horacekj/bcthesis/README.md

# Systém automatické kalibrace modelového železničního vozidla
(Honzova bakalářka)

Tento repozitář obsahuje bakalářskou práci Jana Horáčka vypracovávanou v roce
2018 na Fakultě informatiky Masarykovy univerzity.

Práce je psána v českém jazyce.

HW & FW & SW vyvíjený v rámci práce:

 * [WSM PCB](https://github.com/kmzbrnoI/wsm-pcb)
 * [WSM FW](https://github.com/kmzbrnoI/wsm-fw)
 * [WSM Speed Reader](https://github.com/kmzbrnoI/wsm-speed-reader)
 * [Automatic Calibration SW](https://github.com/kmzbrnoI/automatic-calibration)

## Sestavení práce

Pro sestavení této práce je nutný LaTeX balíček
[fithesis3](https://www.fi.muni.cz/lemma/projekty/fithesis3/). Doporučujeme
použít [Honzův vlastní fork](https://github.com/horacekj/fithesis3).

Pro sestavení stačí spustit
```
$ make all
```
