horacekj/bcthesis/thesis.tex

\documentclass[digital, oneside, table, nolot, nolof]{fithesis3}
%\documentclass[printed, twoside, table, nolot, nolof]{fithesis3}

%% The following section sets up the locales used in the thesis.
\usepackage[resetfonts]{cmap}
\usepackage[T1]{fontenc}
\usepackage[main=czech, english]{babel}

%% The following section sets up the metadata of the thesis.
\thesissetup{
    date          = \the\year/\the\month/\the\day,
    university    = mu,
    faculty       = fi,
    type          = bc,
    author        = Jan Horáček,
    gender        = m,
    advisor       = {RNDr. Zdeněk Matěj, Ph.D.},
    title         = {Systém automatické kalibrace modelového železničního vozidla},
    TeXtitle      = {Systém automatické kalibrace modelového železničního vozidla},
    keywords      = {kalibrace, dcc, vlak, vůz, model, senzor, C++, qt, bluetooth, cv},
    TeXkeywords   = {kalibrace, dcc, vlak, vůz, model, senzor, C++, qt, bluetooth, cv},
    abstract      = {\input{abstrakt.tex}},
    thanks        = {\input{dik.tex}},
    bib           = bibliography.bib,
    titleEn       = {Model Railway Vehicle Automatic Calibration System},
    TeXtitleEn    = {Model Railway Vehicle Automatic Calibration System},
    keywordsEn    = {calibration, dcc, car, model, sensor, C++, qt, bluetooth, cv},
    TeXkeywordsEn = {calibration, dcc, car, model, sensor, c++, qt, bluetooth, cv},
    assignment    = {data/zadani_ofic.pdf},
}
\usepackage{makeidx}      %% The `makeidx` package contains
\makeindex                %% helper commands for index typesetting.
%% These additional packages are used within the document:
\usepackage{paralist} %% Compact list environments
\usepackage{amsmath}  %% Mathematics
\usepackage{amsthm}
\usepackage{amsfonts}
\usepackage{url}      %% Hyperlinks
\usepackage{listings} %% Source code highlighting
\usepackage{enumitem}
\usepackage{afterpage}
\usepackage{glossaries}
\makeglossaries
\lstset{
  basicstyle      = \ttfamily,%
  identifierstyle = \color{black},%
  keywordstyle    = \color{blue},%
  keywordstyle    = {[2]\color{cyan}},%
  keywordstyle    = {[3]\color{olive}},%
  stringstyle     = \color{teal},%
  commentstyle    = \itshape\color{magenta}}
\usepackage{floatrow} %% Putting captions above tables
\floatsetup[table]{capposition=top}
\Urlmuskip=0mu plus 1mu
\begin{document}

% Highlight overfulls
% \setlength{\overfullrule}{5pt} % TODO: remove

\setlength{\parindent}{0cm}
\setlength{\parskip}{3mm plus2pt minus2pt}
\setlist{leftmargin=8mm}
\renewenvironment{compactenum}
	{\begin{enumerate}[leftmargin=8mm,itemsep=0pt,parsep=1pt,topsep=1pt,partopsep=1pt]}
	{\end{enumerate}}
\renewenvironment{compactitem}
	{\begin{itemize}[leftmargin=8mm,itemsep=0pt,parsep=0pt,topsep=1pt,partopsep=1pt]}
	{\end{itemize}}

\input{zkratky}

\chapter{Úvod} \label{chap:uvod}
\input{uvod}

\chapter{Požadavky na řešení} \label{chap:pozadavky}
\input{pozadavky}

\chapter{Existující řešení} \label{chap:prehled}
\input{prehled}

\chapter{Měřicí vůz} \label{chap:merici-vuz}
\input{merici-vuz}

\chapter{Software} \label{chap:sw}
\input{sw}

\chapter{Závěr} \label{chap:zaver}
\input{zaver}

\printbibliography[heading=bibintoc]

\appendix
\chapter{Přílohy} \label{chap:appendix}
\input{appendix}

\end{document}
