horacekj/bcthesis/pres/defense.tex

\documentclass[aspectratio=169]{beamer}

\mode<presentation> {
	\usetheme{Madrid}
	\usecolortheme{beaver}
}

\setbeamertemplate{footline}{}
\beamertemplatenavigationsymbolsempty
\definecolor{beamer@blendedblue}{rgb}{0.8,0,0}

\usepackage[czech]{babel}
\usepackage[utf8]{inputenc}
\usepackage[T1]{fontenc}
\usepackage{lmodern}
\usepackage{graphicx}
\usepackage{graphbox}
\usepackage{booktabs}
\usepackage{hyperref}

\deftranslation[to=Czech]{Example}{Příklad}

\title[Automatická kalibrace]{Systém automatické kalibrace modelového
železničního vozidla}

\author{Jan Horáček}
\institute[FI MUNI]{
	Fakulta informatiky \\
	Masarykova univerzita \\
	\medskip
	\textit{horacekj@mail.muni.cz}
}
\date{7. února 2019}

\begin{document}

%------------------------------------------------

\begin{frame}
\titlepage
\end{frame}

%------------------------------------------------

\begin{frame}
\frametitle{Cíl práce}
\begin{block}{Cíl práce}
Cílem práce je automatizovat proces kalibrace modelové lokomotivy.
\end{block}
\end{frame}

%------------------------------------------------

\begin{frame}
\frametitle{Kontext: řízení kolejiště}
\begin{figure}
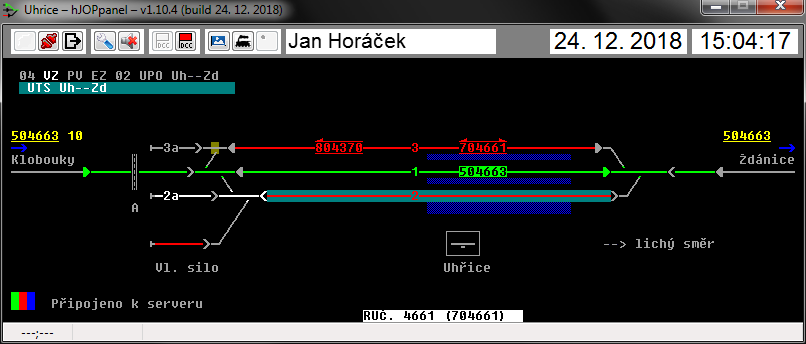
[picture p1: pres/data/hJOPpanel-uh.png]

\end{figure}
\end{frame}

%------------------------------------------------

\begin{frame}
\frametitle{Kontext: řízení kolejiště}
\begin{figure}
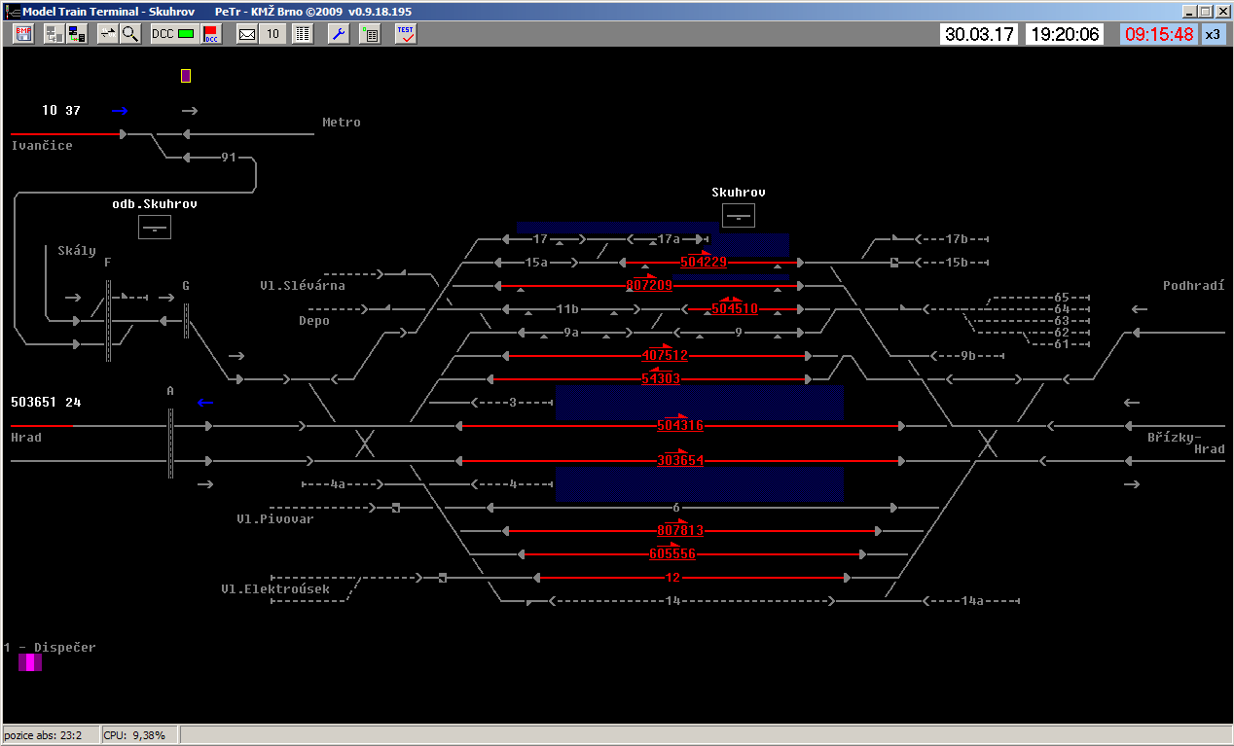
[picture p2: pres/data/JOP2-SkLogin.png]

\end{figure}
\end{frame}

%------------------------------------------------

\begin{frame}
\frametitle{Kontext: digitální řízení vlaku}
\begin{columns}
	\begin{column}{.8\textwidth}
		Digital Command Control (DCC):
		\begin{itemize}
		\item Každá lokomotiva obsahuje miniaturní počítač, tzv. \uv{dekodér}.
		\item DCC centrála generuje data pro lokomotivy (tzv. \textit{DCC signál}).
		\item Lokomotiva data přijímá a na základě nich koná akce.
		\item Lokomotiva je identifikována adresou (typicky $1$--$9999$).
		\item Centrála generuje DCC signál na základě povelů z~ovladačů.
		\begin{itemize}
		\item ruční ovladač, počítač, ...
		\end{itemize}
		\item Dekodér je možno konfigurovat: ukládat do něj číselné hodnoty do jednotlivých
		konfiguračních slotů (tzv. \textit{CV}).
		\end{itemize}
	\end{column}
	\begin{column}{.2\textwidth}
		
	\end{column}
\end{columns}
\end{frame}

%------------------------------------------------

\begin{frame}
\frametitle{Kontext: řízení kolejiště počítačem}
\begin{itemize}
\item Jízdu vlaku řídí počítač, obsluha vydává povely typu: \uv{Vlaku 8013, jeď
na třetí kolej do vedlejší stanice.}
\item Správce systému volí, jak rychle se mají kde vlaky pohybovat (km/h).
\item Rychlost lokomotivy z~pohledu dekodéru = číslo $0$--$28$.
\end{itemize}
$\Rightarrow$ Nutnost spárovat skutečnou rychlost a~jízdní stupeň.
\end{frame}

%------------------------------------------------

\begin{frame}
\frametitle{Kalibrace}
\begin{block}{Kalibrace}
\begin{enumerate}
\item Nakonfigurování dekodéru tak, aby konkrétnímu jízdnímu stupni odpovídala
konkrétní skutečná rychlost.
\item Nakonfigurování dekodéru tak, aby z~rychlosti $40$~km/h mělo hnací vozidlo
brzdnou dráhu $30$--$35$~cm.
\end{enumerate}
\end{block}

\begin{block}{Vybrané přínosy}
\begin{itemize}
\item Zastavení vlaku na správném místě.
\item Očekávatelné prostředí pro obsluhu.
\item Přípřeže, postrky.
\end{itemize}
\end{block}

Současná kalibrace je ruční $\Rightarrow$ automatizovat.
\end{frame}

%------------------------------------------------

\begin{frame}
\frametitle{Obsah práce}
\begin{enumerate}
\item Nástroj pro měření rychlosti: měřicí vůz.
\item Počítačový program.
\end{enumerate}
\end{frame}

%------------------------------------------------

\begin{frame}
\frametitle{Měřicí vůz}
\begin{columns}
	\column{.4\textwidth}
	\begin{center}
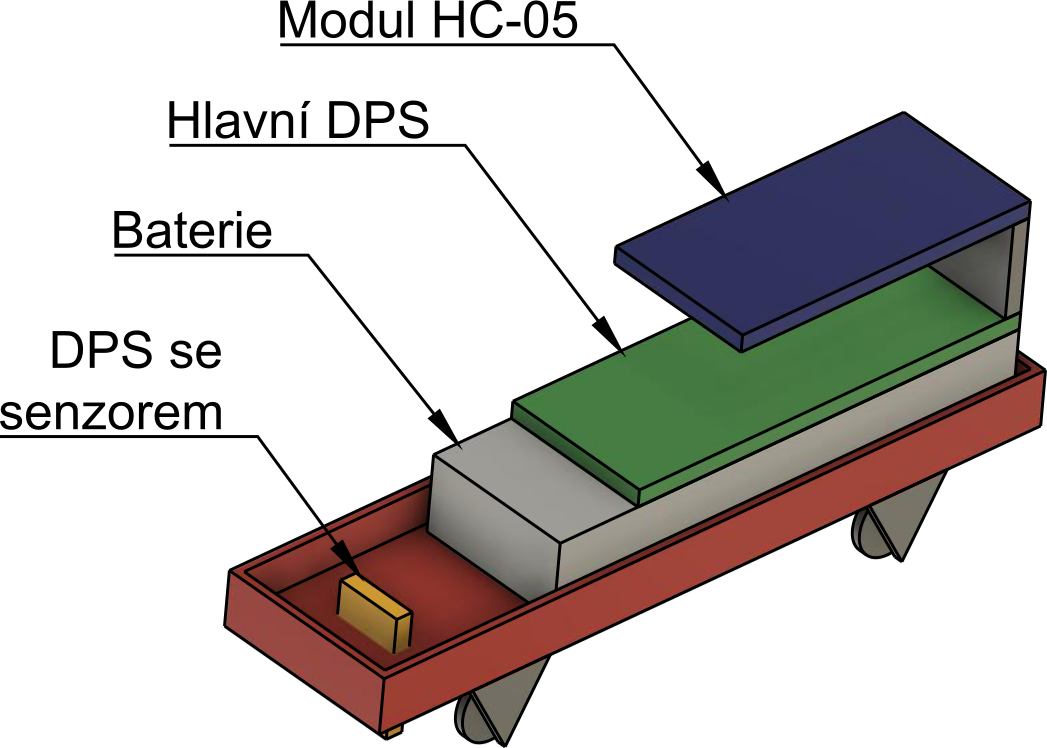
[picture p3: pres/data/wsm-3d.png]
	
	
	\end{center}
	\pause
	\column{.5\textwidth}
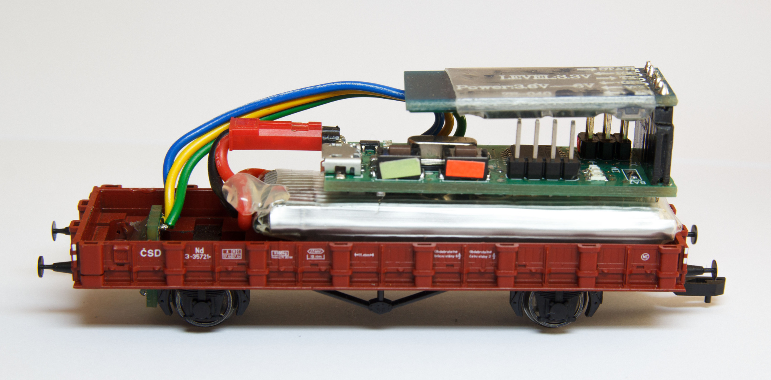
[picture p4: pres/data/wsm-3d.jpg]
	
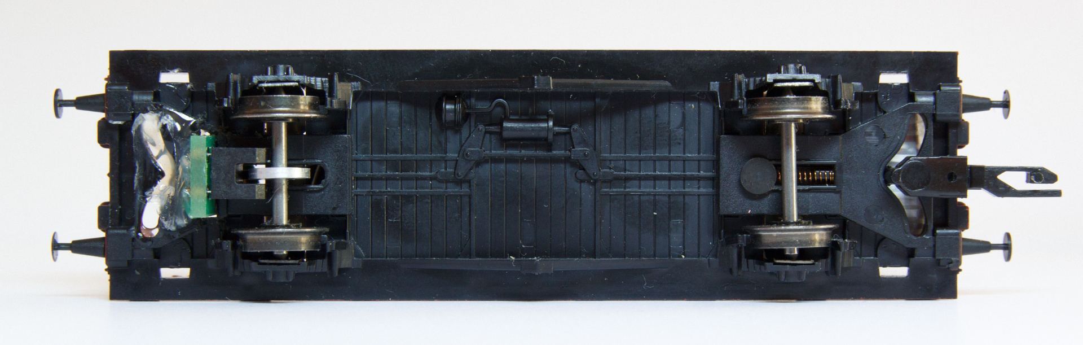
[picture p5: pres/data/wsm-bot.jpg]
	
\end{columns}
\end{frame}

%------------------------------------------------

\begin{frame}
\frametitle{Software}
\begin{columns}[t]
	\column{.35\textwidth}
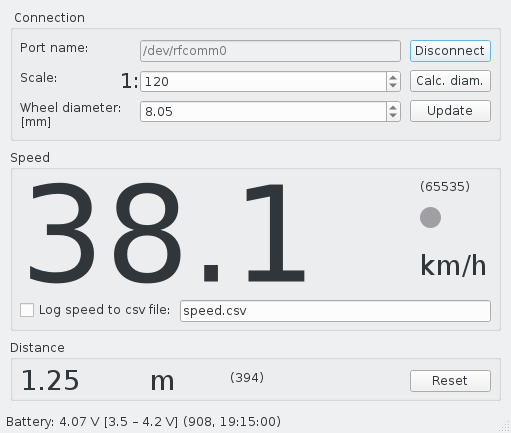
[picture p6: pres/data/speed_reader_screenshot.png]
	
	\pause
	\column{.65\textwidth}
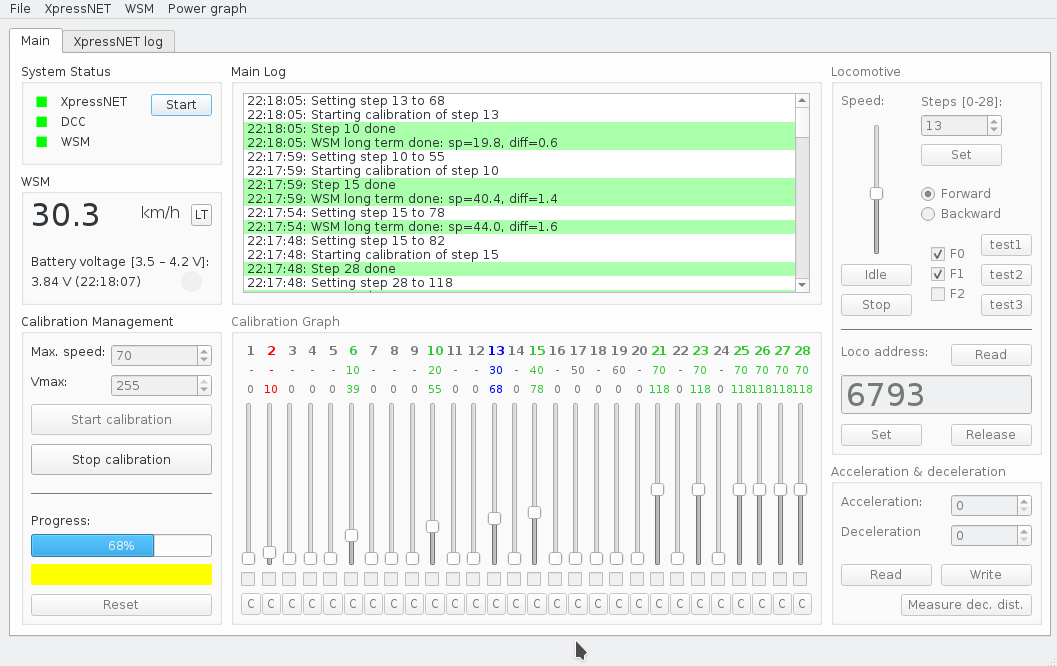
[picture p7: pres/data/ac_progress.png]
	
\end{columns}
\end{frame}

%------------------------------------------------

\begin{frame}
\frametitle{Přínos}
\begin{itemize}
\item Fungující proof-of-concept.
\item Kalibrace: 25 minut + člověk $\rightarrow$ 4 minuty autonomně.
\item Univerzální měřicí vůz.
\item Zajímavá naměřená data.
\item Vytvořena spousta užitečného opensource SW (XpressNET knihovna).
\end{itemize}
\end{frame}

%------------------------------------------------

\end{document}
