horacekj/bcthesis/declaration/declaration.tex

\documentclass[12pt,a4paper]{article}
\usepackage[unicode,colorlinks=true]{hyperref}
\usepackage[czech]{babel}
\usepackage[utf8]{inputenc}
\usepackage[T1]{fontenc}
\usepackage{lmodern}
\usepackage{graphicx}
\usepackage{fontspec}
\textheight = 37\baselineskip
\textwidth 5.1truein
\oddsidemargin 0.75in
\evensidemargin 0.4in
\marginparwidth 0pt
\begin{document}
\pagestyle{empty}

% Highlight overfulls
%\setlength{\overfullrule}{5pt} % TODO: remove

\setlength{\parindent}{0cm}
\setlength{\parskip}{3mm plus2pt minus2pt}
\setmainfont[Ligatures=TeX]{TeX Gyre Pagella}

\section*{Prohlášení autora školního díla}

\textbf{Jméno, příjmení a~UČO studenta: Jan Horáček, 445326}

Beru na vědomí, že Masarykova univerzita může na základě zákona (§~35 odst.
3 a 4 autorského zákona č. 121/2000 Sb.) užít mou kvalifikační práci nebo jiné
mé školní dílo, které jsem jako autor vytvořil ke splnění svých studijních
povinností vůči této vysoké škole, a to k~výuce nebo k~její vlastní vnitřní
potřebě nikoli za účelem přímého nebo nepřímého obchodního nebo jiného
hospodářského prospěchu.

Vlastní vnitřní potřebou Masarykovy univerzity se rozumí užití díla nejen
v původní podobě, ale též ve zpracované nebo jinak změněné podobě zahrnující
též takové užití mého díla touto vysokou školou, které spočívá v zadání mého
školního díla k~dalšímu zpracování jinému studentovi této vysoké školy
(členovi téže akademické obce) za účelem vytvoření další kvalifikační práce
nebo jiného školního díla, které bude odvozené od mého díla při uvedení mého
autorství, názvu mého díla a pramene; a~to vše v~souladu s~rozvojem
vzdělanosti na Masarykově univerzitě a zájmem této veřejné vysoké školy
navazovat na výsledky mé práce a mé školní dílo dále rozpracovávat v~téže
akademické obci.

Okolnosti hodné zvláštního zřetele z mé strany, například zájem o~vlast\-ní
další rozpracování své kvalifikační práce na Masarykově univerzitě nebo
jinde, jsem povinen sdělit této vysoké škole prostřednictvím studijního
oddělení nejpozději při odevzdání kvalifikační práce.

\vskip 2cm
V~Brně dne 26. 11. 2018
\hfill
Jan Horáček
\par\vfill

\end{document}
