horacekj/bcthesis/(list of files, cad)

Other CAD files:
data/wsm-3d.f3d
