horacekj/bcthesis/(threads)

Thread 17 (2018-11-11):

Poznámky od Zdeňka

horacekj, 2018-11-11:
* [x] Abstrakt - myslis ze prispely i k bezpecnejsimu provozu?
* [x] Obsah - prejmenoval bych 3.5 na Shrnuti - Zaver bych si nechal jinam
* [x]  Uvod - upravil bych asi "autor demonstruje vystupy..." na "autor popisuje vystupy.." v textu to asi jinak nepujde
* [x]  zarazeni prace - tento odstavec bych klidne vypustil - zda se mi divny a nasleduji odstavec take
* [x] Celou kapitolu 1 popisujes hodne z vlackarskeho pohledu - predpokladam ze schvalne, kdyz jsem se s tim seznamil u tebe tak mi to dava smysl, ale nejsem si jist zda by to tak bylo i bez navstevy. Za me dobre.
* [x] Casteji se vyskytuje slovo zasadni - neslo by nekde nahradit/vypustit?
* [x] Strana 18. - "autor zakoupil..." touhle vetu bych prepracoval a vypustil autora -> napr: senzor byl zapojen na vyvojovy kit Arduino... a stejne tak i v dalsim textu bych prepsal: autor neco udelal...
* [x] Sbirani napajeni z koleji je asi zvladnutelne dobre - koukni kolik ma spotrebu lokomotiva a necuka - jen to chce lepsi mech. reseni - jak jsme rozebirali na schuzce - asi bych to zminil v kapitole 4.3 baterii bych vyzdvihl jako univerzalni bez nutnosti upravovat vagonky
* [x] prenos dat mohl byt i ve variante 3. jako prenos po kolejich coz by bylo take vhodne popsat - dobre oduvodnit vyber univerzalniho bezdratu
* [x] 4.5.1 - hantyrka - taktovat procesor - lepe formulovat
* [x]  zase se opakuje - autor ... (casto) - vhodne prepsat a vyhybat se autor udelal -> bylo udelano - sjednoti se to s celym textem
* [x] str. 34 - Všimněte si, že rozsah na ose y je asi 4× menší než rozsah v grafu 4.5, přesto není oscilace na tomto grafu patrna - nejedna se o zmenu meritka - nez popis rozsahu???
* [x] str. 35 - Zde se pouštíme už na poměrně tenký led. - tohle bych nepsal
* [x] str. 37 pred Jedna sekunda ma byt asi tecka
* [x] klidne bych se nabal k obrazku 5.2 udelat sipky a popsat jednolive casti v obrazku
* [x] V zaveru - napr: podarilo se mu - co treba jen: podarilo se
* [x] Mozna zlepseni- doplnil bych sbirani energie z koleji a komunikace taktez pres koleje
* [x] ad schema - to rizeni ledek 0 je proste divne - dobre, ale divne

horacekj, 2018-11-16:
Hotovo.

Closed 2018-11-16.
