horacekj/bcthesis/data/ac_classes.pdf

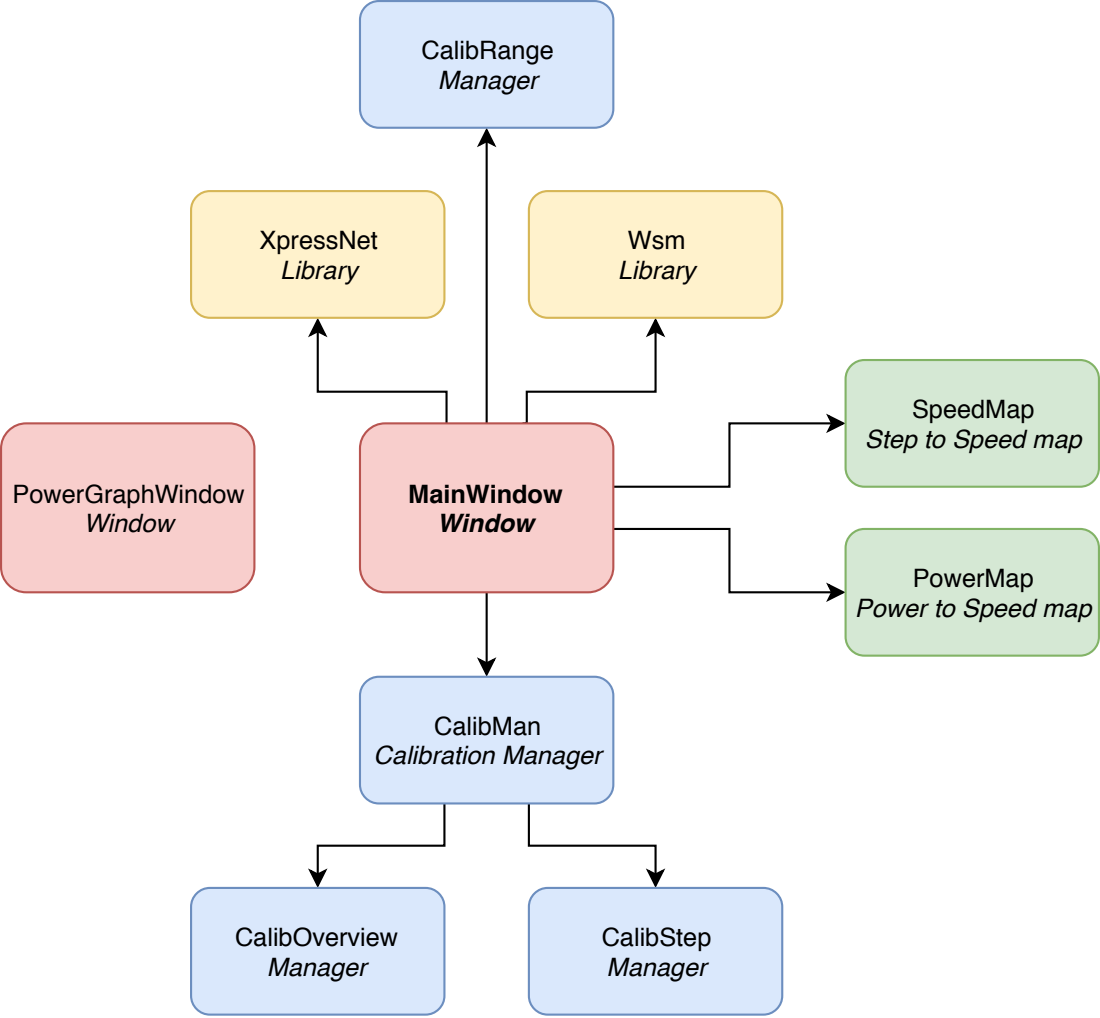
[picture p10: page 1]
MainWindow Window; XpressNet Library; Wsm Library; PowerGraphWindow Window; CalibMan Calibration Manager; CalibStep Manager; CalibOverview Manager; CalibRange Manager

SpeedMap
Step to Speed map

PowerMap
Power to Speed map
