horacekj/bcthesis/data/wheel.pdf

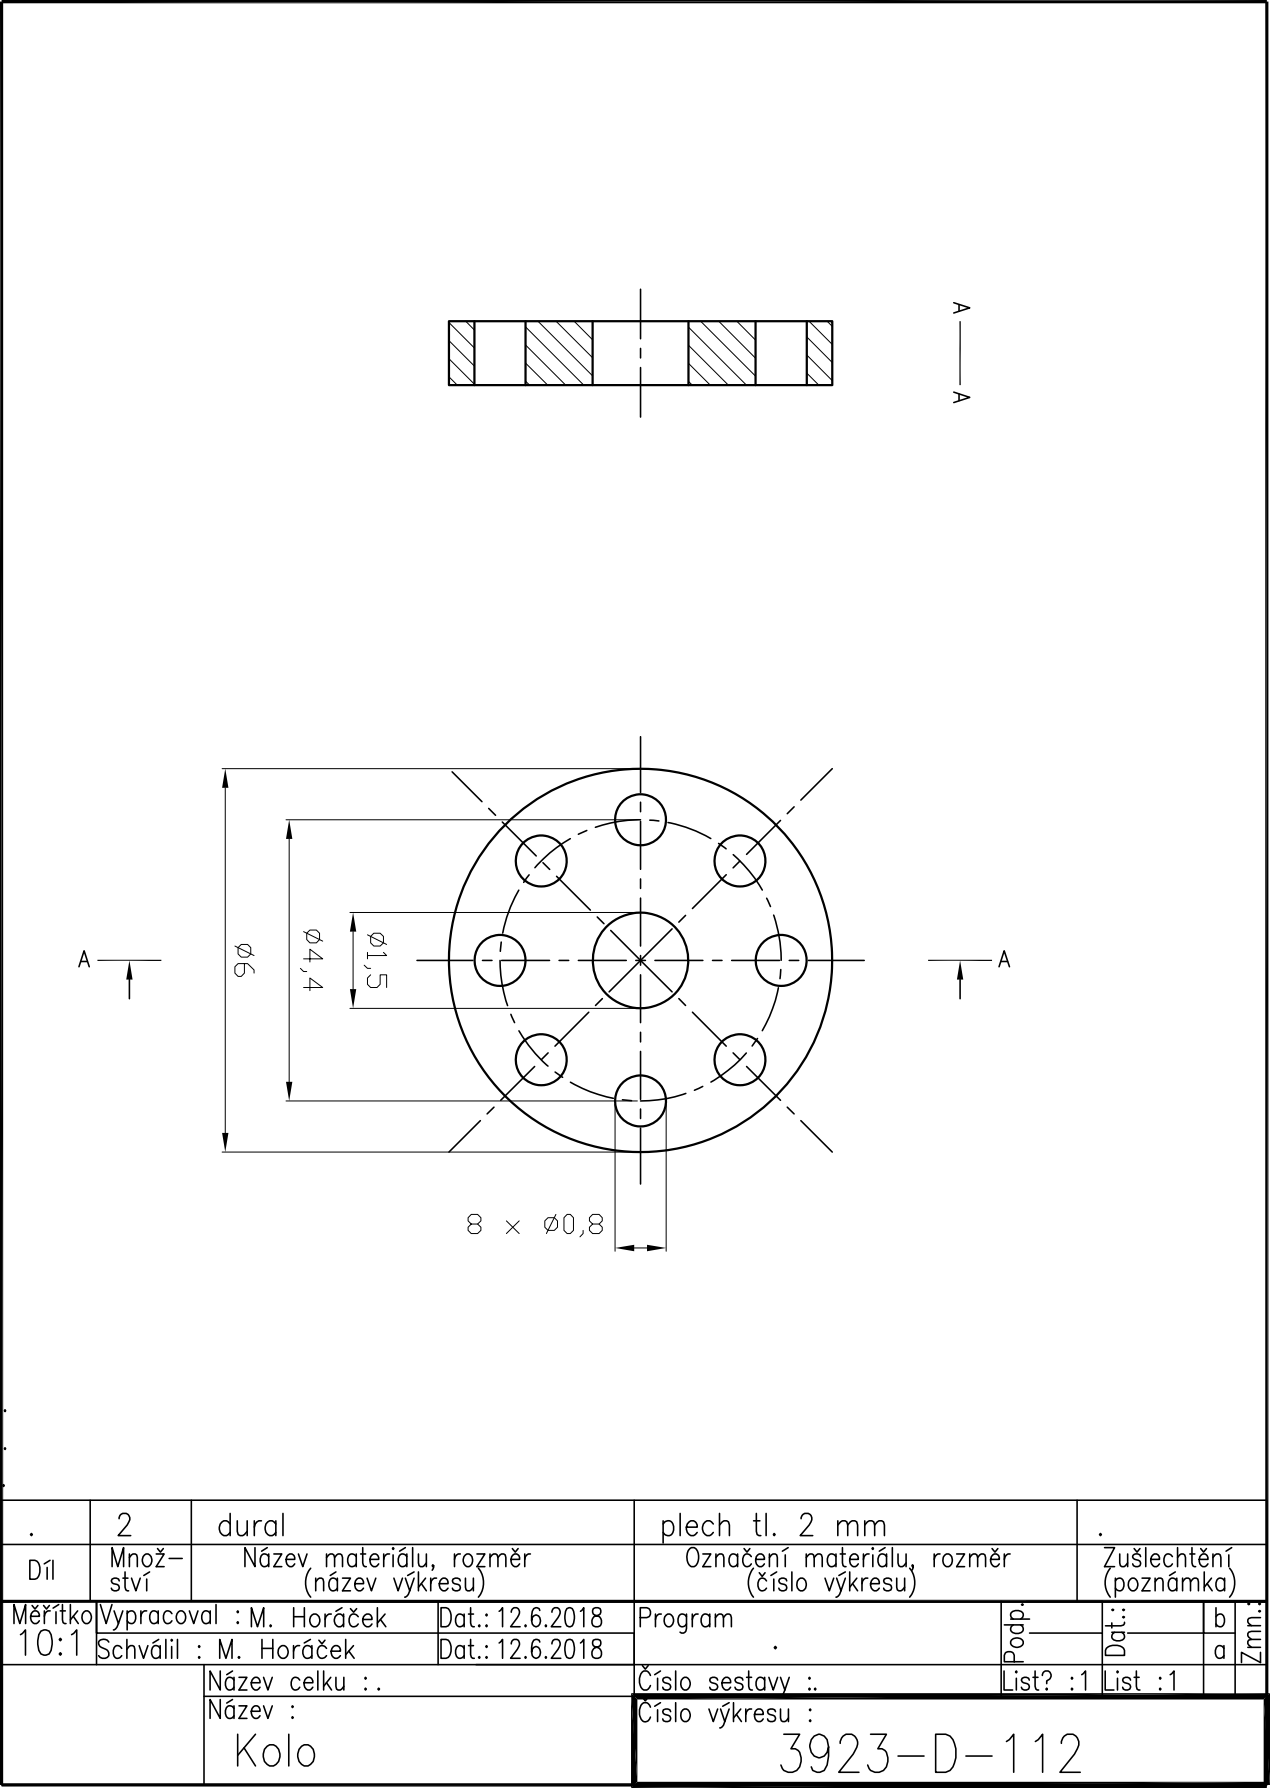
[picture p11: page 1]
