horacekj/bcthesis/data/wsm_main_board_v1_3.pdf

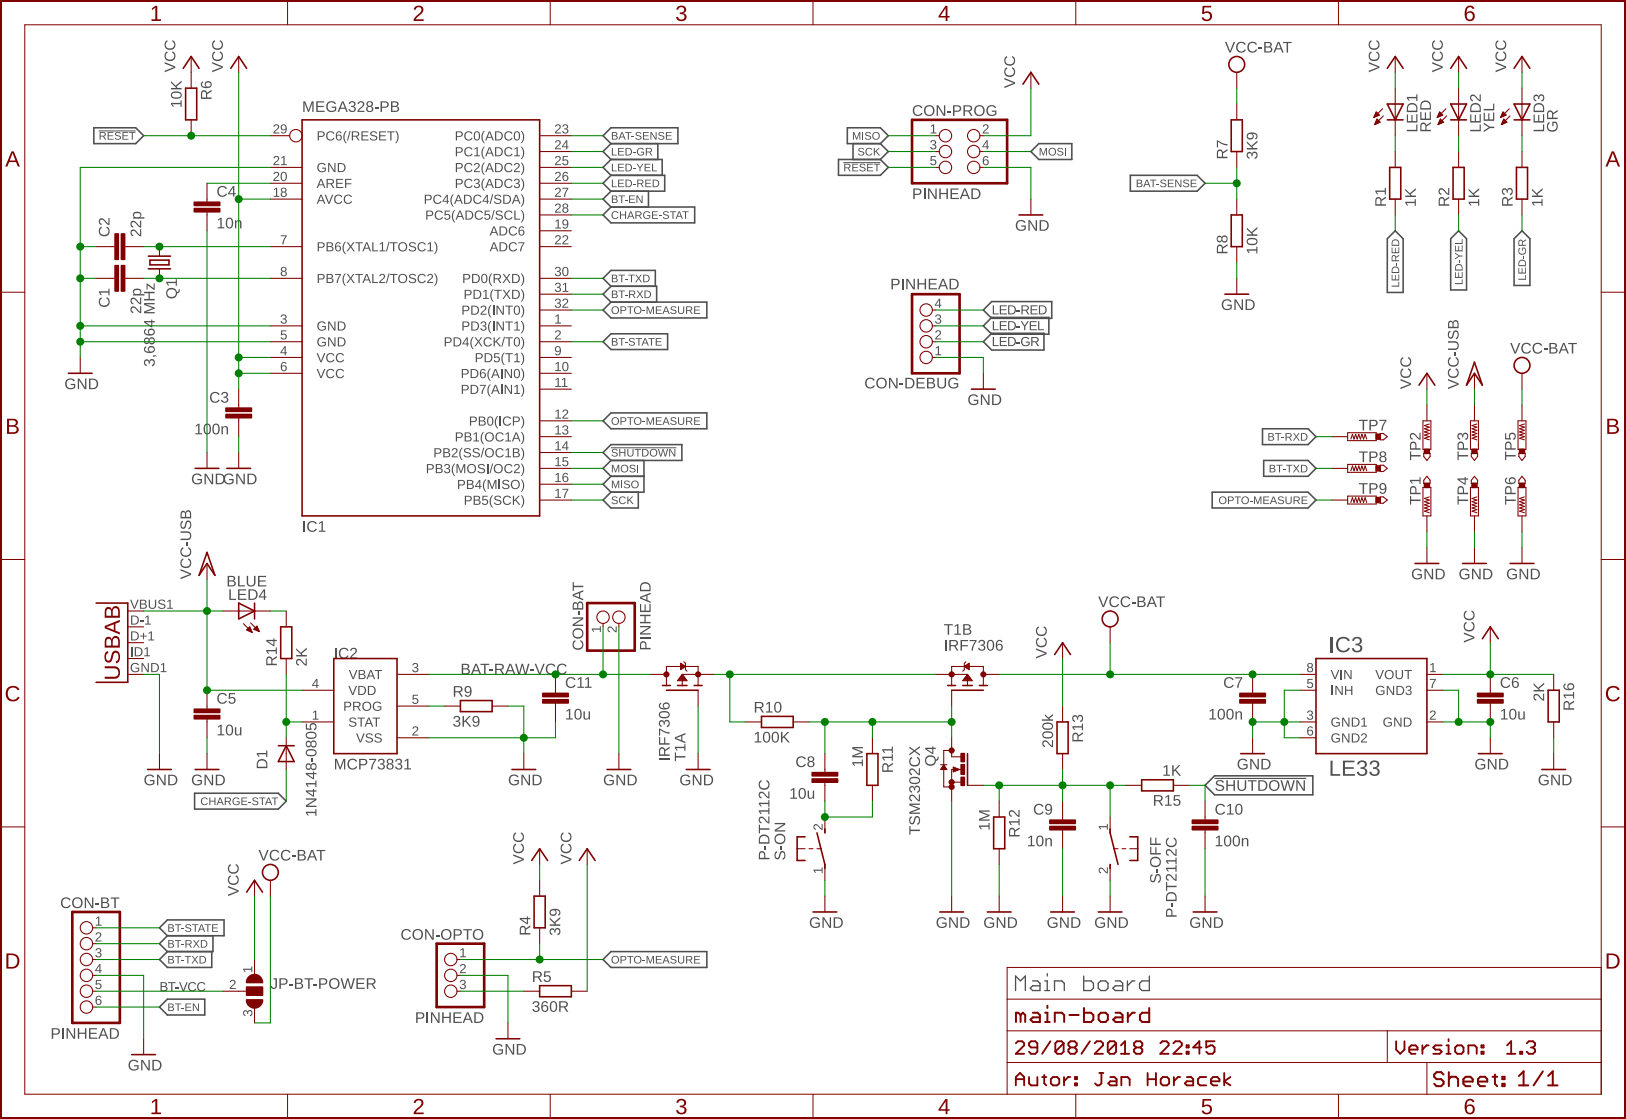
[picture p12: page 1]
