horacekj/bcthesis/pres/data/DCC_scheme.pdf

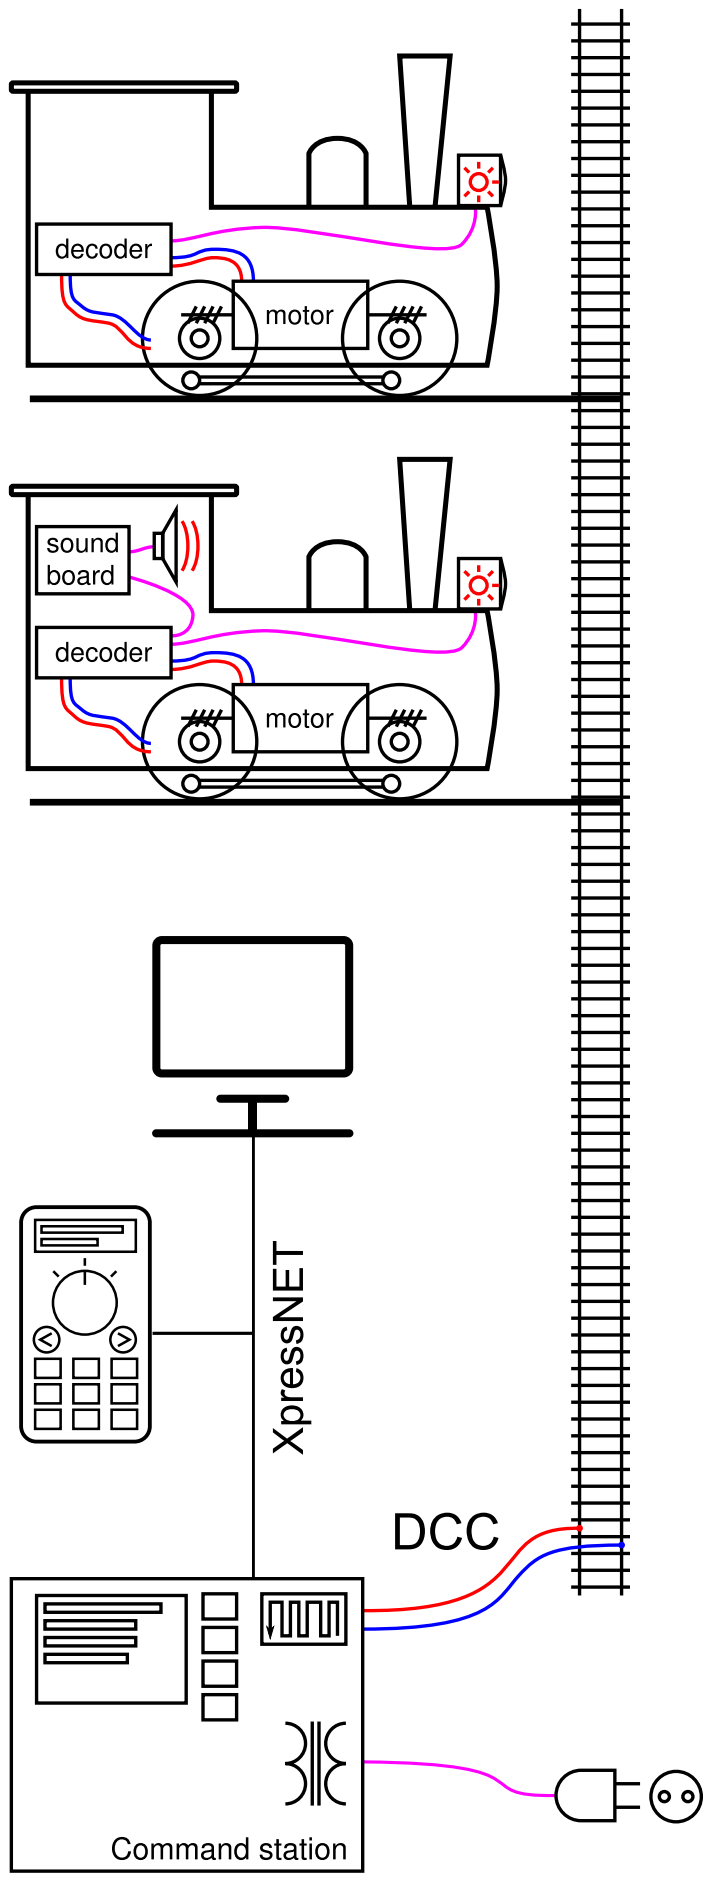
[picture p13: page 1]
