horacekj/bcthesis/pres/data/Kolo_pres_TT.pdf

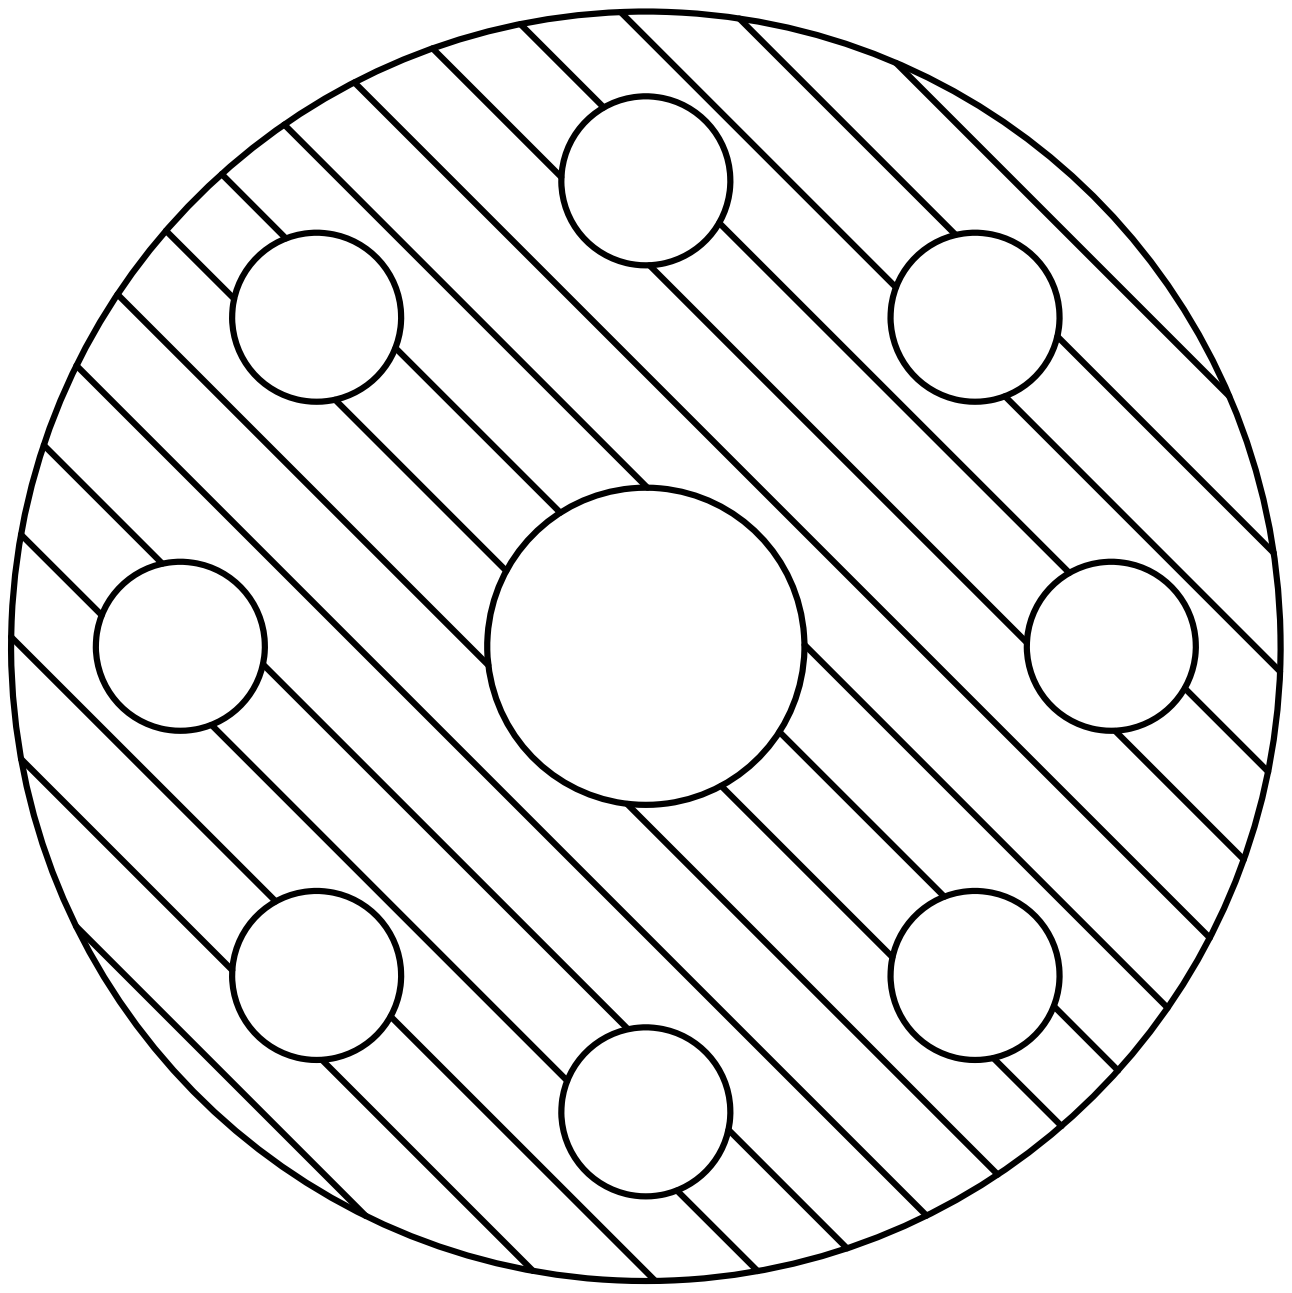
[picture p14: page 1]
