horacekj/bcthesis/(commit log)

2018-03-31 Add seciton about calibration.
2018-09-22 Measure car: add magnetic sensors.
2018-09-23 Measure car: add power supply.
2018-09-26 Add reference to magnetic sensors.
2018-09-26 Explain 'kinematika'.
2018-10-01 Graph: add method & speed_zduch.
    [speed_zduch.csv]
2018-10-01 Resources: add magnetic sensor illustration.
2018-10-01 Graph: add analog.
    [speed_analog.csv]
2018-10-01 Graph: add detail.
    [speed_detail.csv]
2018-10-01 Graph: add averaging graph.
    [speed_prumer.csv]
2018-10-04 Add appendix & wsm pcb scheme.
2018-10-05 Add drawing of a wheel.
2018-10-05 Appendix: add final wheel drawing.
2018-10-16 Wsm: add "calibration of WSM".
    Close #6.
2018-10-21 Ac: add info about decel calibration.
2018-10-23 Clarify sensor vs, detector.
2018-10-27 Add 3D model of WSM.
    [wsm-3d.f3d]
2018-10-27 Reformulate magnetic sensor.
2019-02-03 Defense: add perforated wheel data file.
2019-02-03 Remove dimensions from wheel.
2019-02-03 Wheel: increase lineweight.
2019-02-03 Add DCC schematics.
2019-02-03 Add images of wheel & layout to defense.
